willscott/clockOS/README.md

Clock OS
========

This is a mirror of the abandonware resources associated with the
[clockOS](https://www.kickstarter.com/projects/threetree/clockos-rgb-led-clock-arduino-programable-0)
kickstarter project.
