willscott/clockOS/Docs/main.pdf

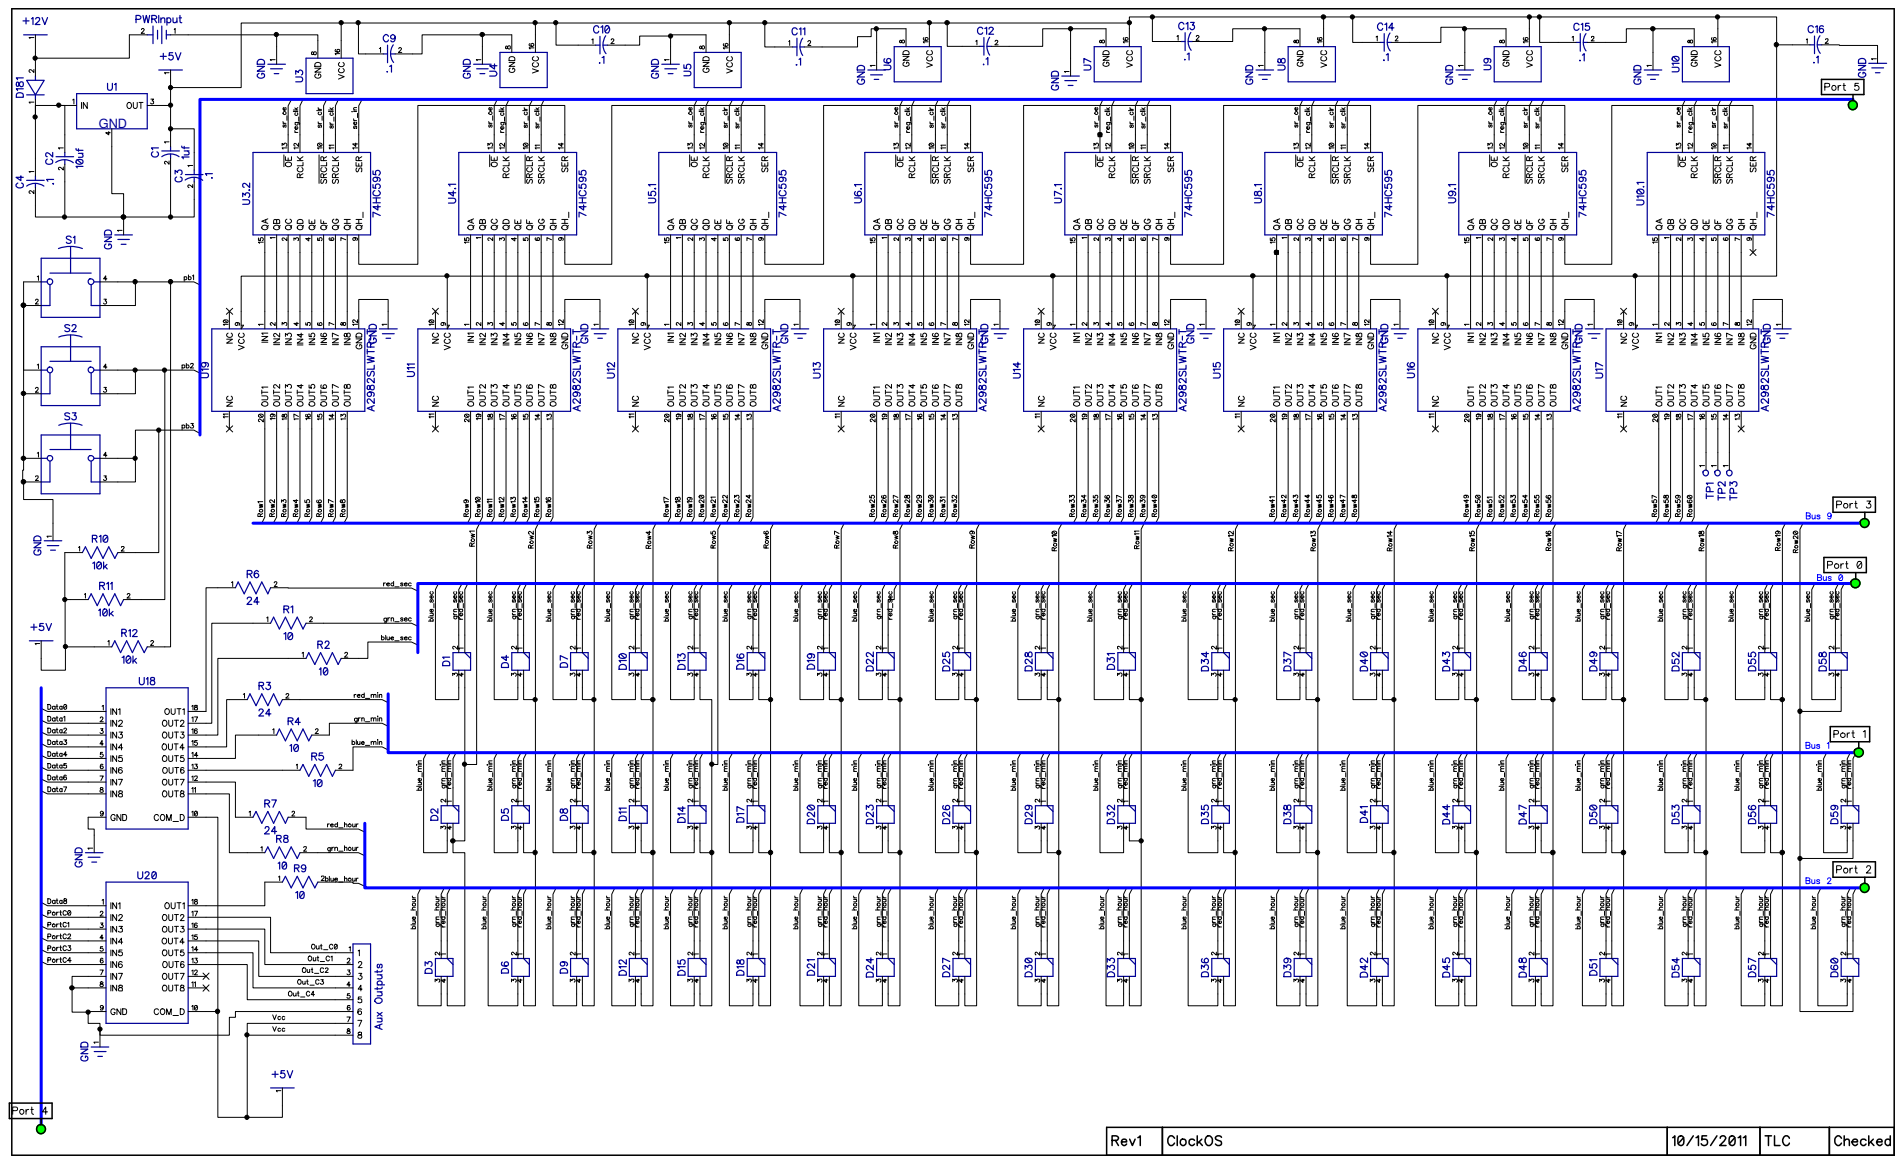
[picture p9: page 1]
GND
