willscott/clockOS/Docs/parts_1.pdf

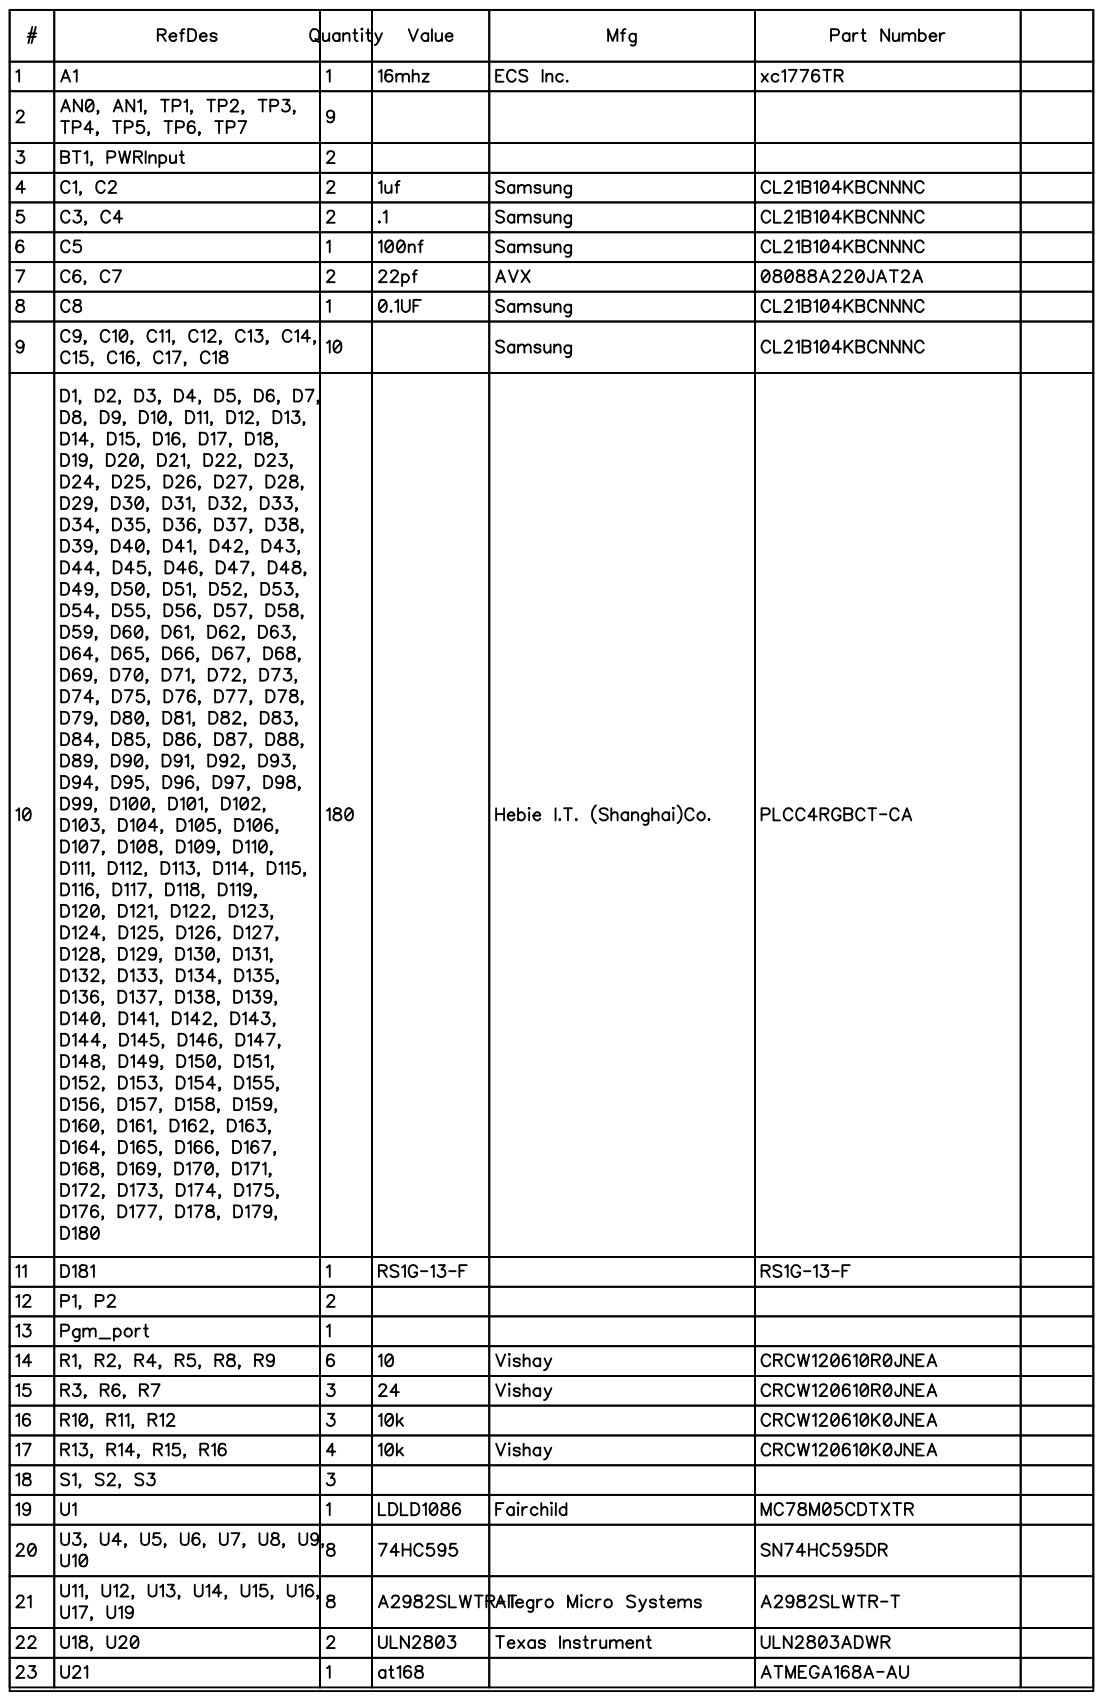
[picture p10: page 1]
