willscott/clockOS/Docs/parts_2.pdf

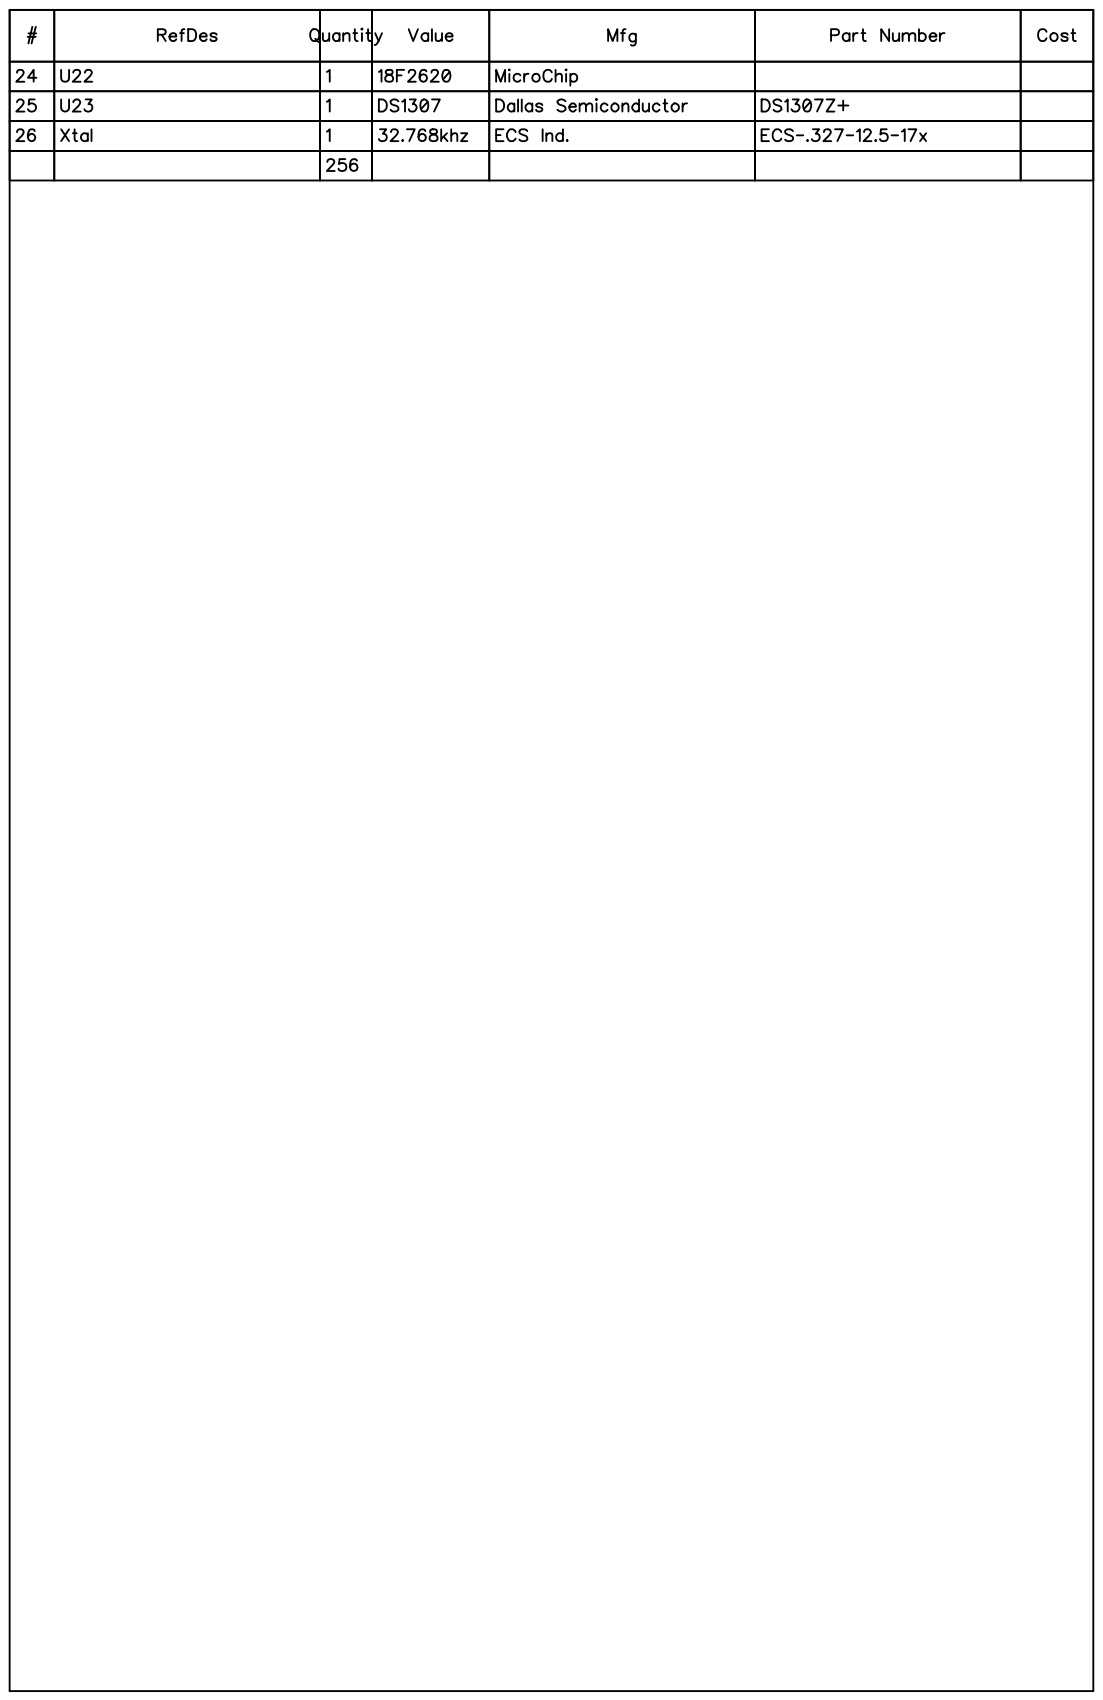
[picture p11: page 1]
