willscott/clockOS/Docs/leds.pdf

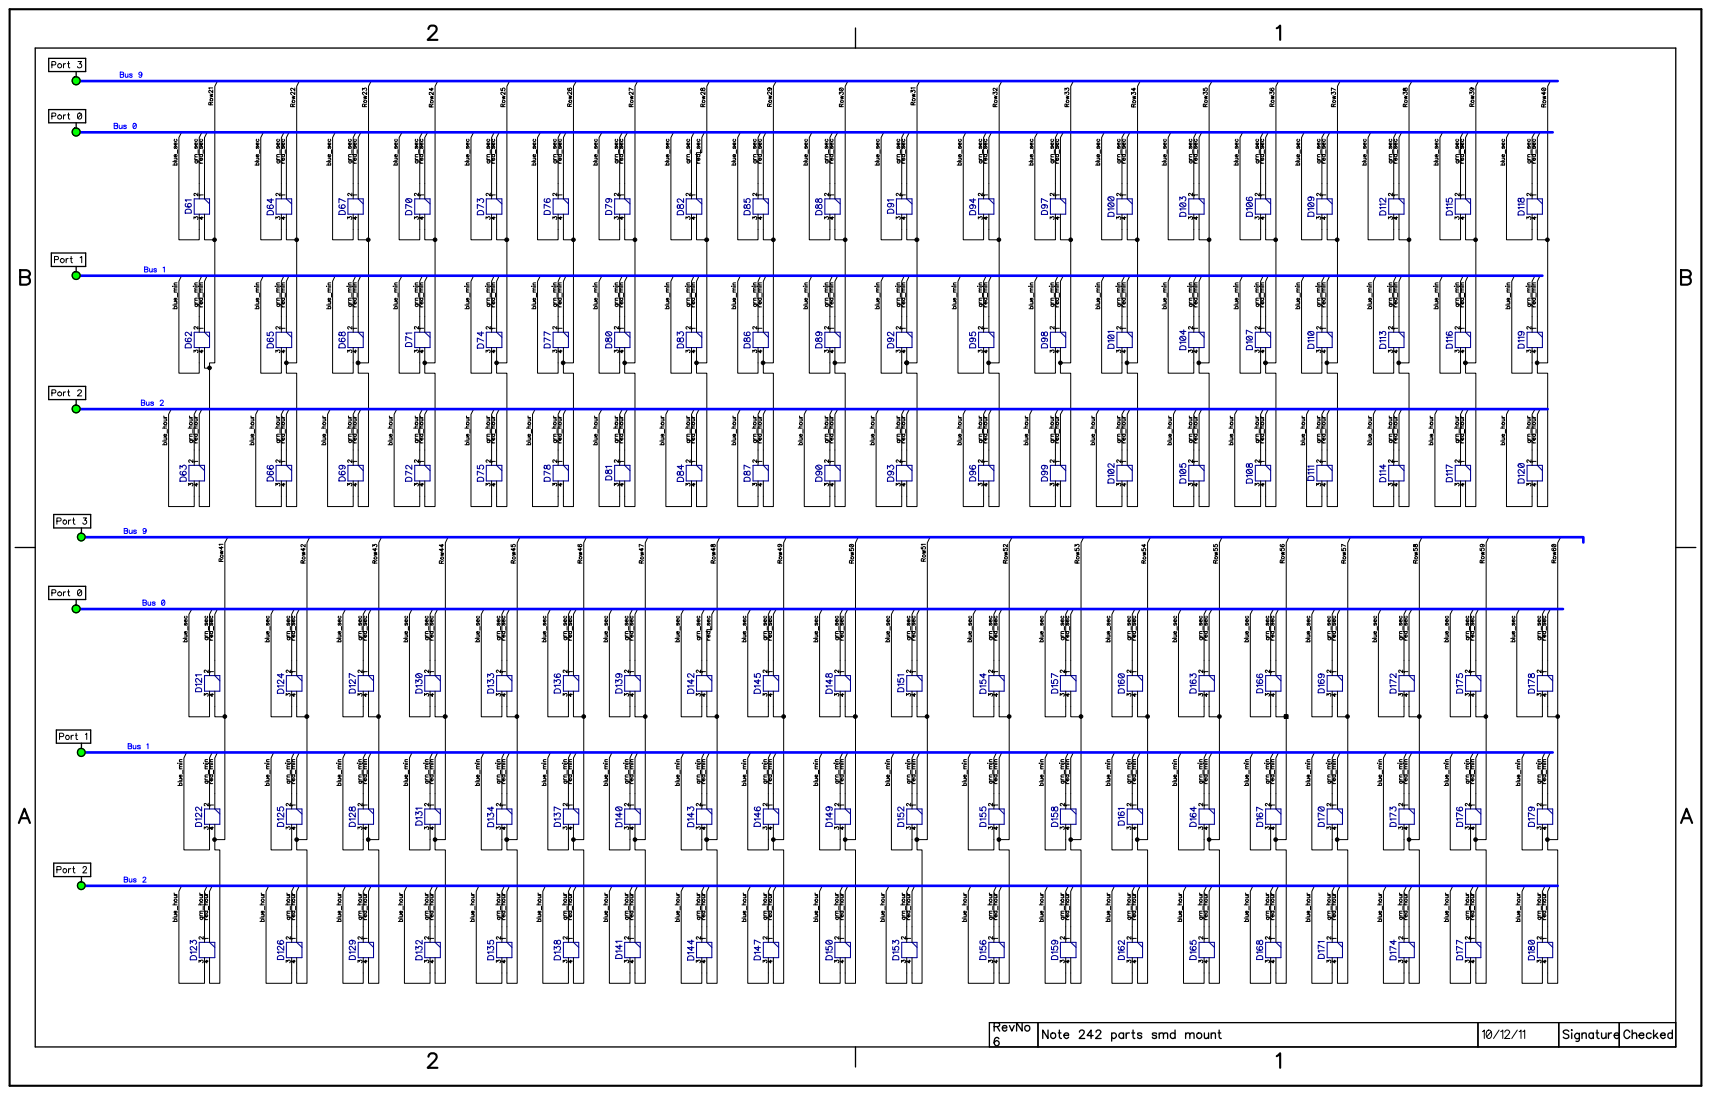
[picture p12: page 1]
