willscott/clockOS/Docs/processor.pdf

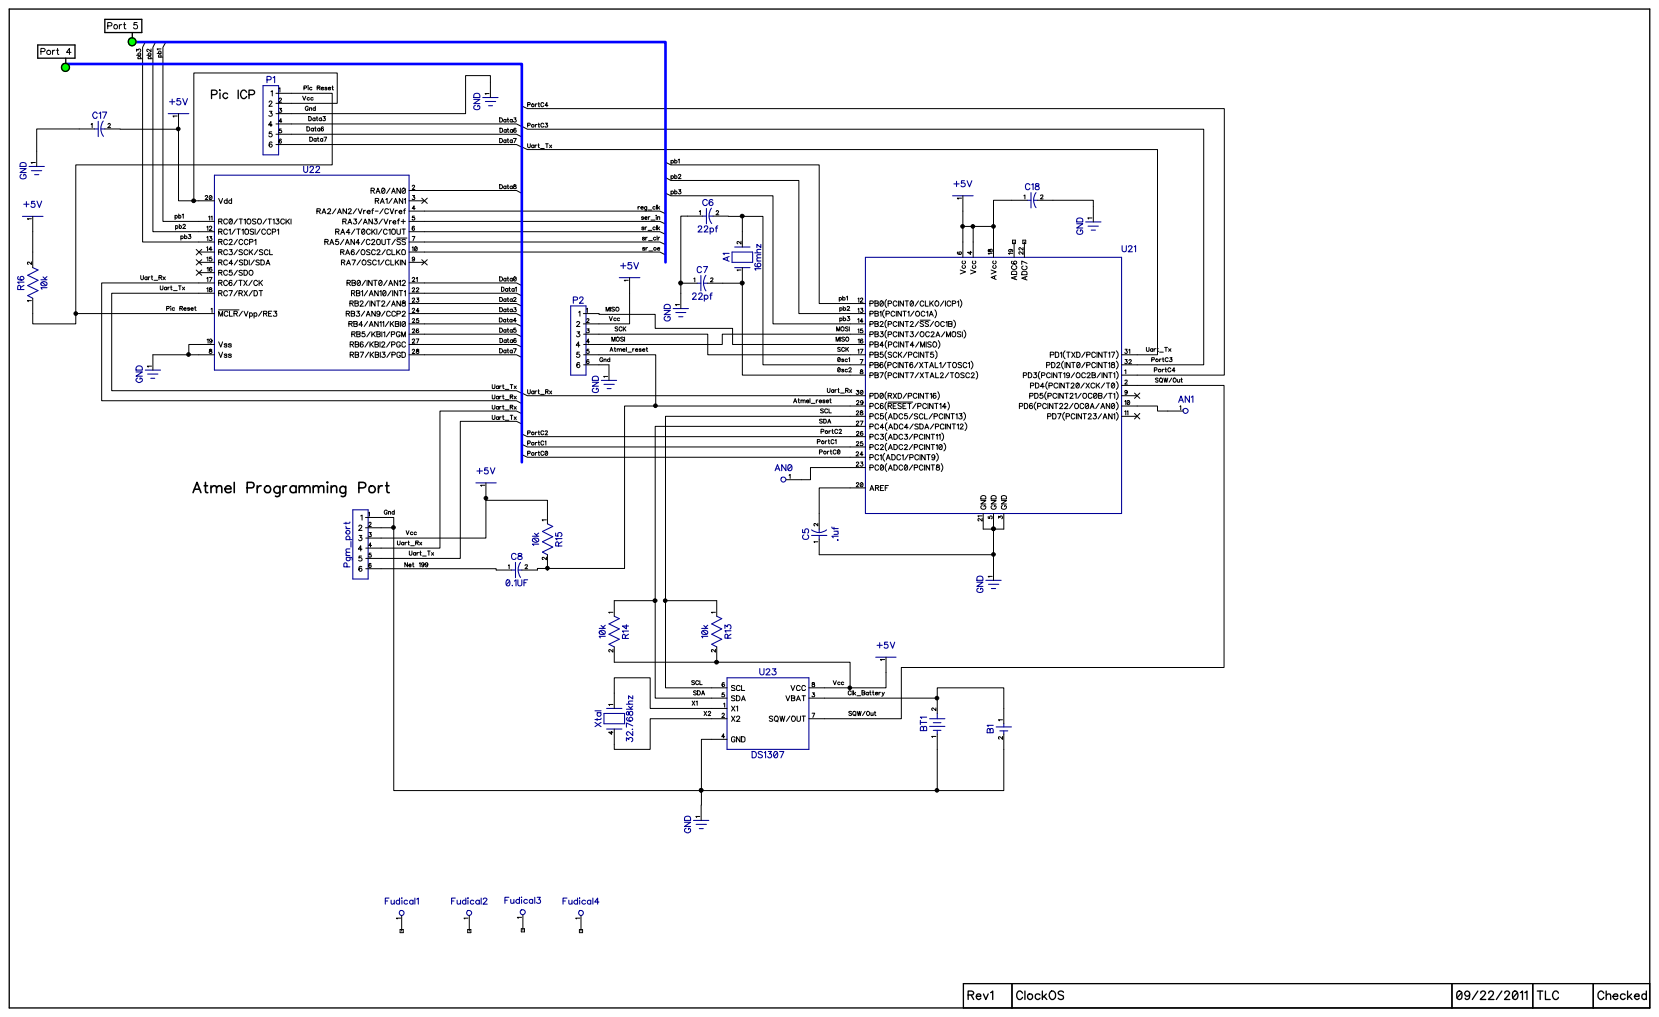
[picture p13: page 1]
